SaBuMa/MEDICION-ANGULAR/Readme.md

# Medicíon Angular
***Resumen*** Este documento muestra la concepción, diseño,  implementación y operación de un sistema capaz de medir posición angular por medio de un Synchro/Resolver. Además, se presenta lo fundamental de la teoría para entender el funcionamiento del dispositivo junto con los resultados obtenidos.

***Abstract*** This paper presents from scratch the design process, the workings and the way to do a system capable of measuring the angular position using a Synchro/Resolver. Furthermore it is presented as the fundamental theory to understand the device along with the results obtained.  

Como características funcionales de este proyecto se tienen:

* Se diseñó e implementó un oscilador “puente de wien”, el cual es capaz de oscilar a una frecuencia de 400 Hz, con máxima excursión en su salida.

<p align="center">
<b>Esquemático del oscilador "Puente de Wien"</b>
</p>

<p align="center">
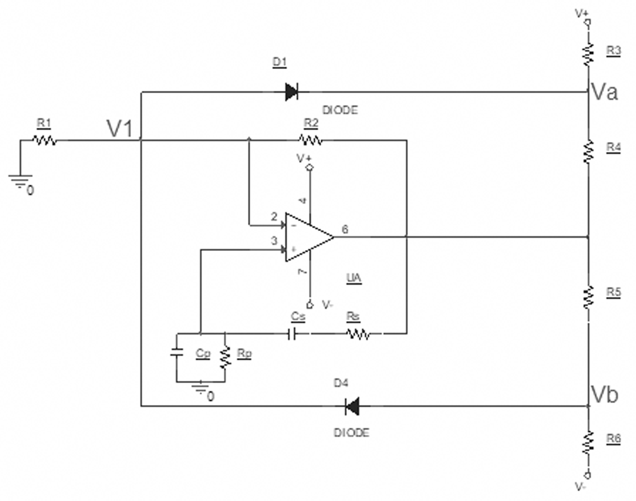
[picture p1: Git_Images/WEIN.png]
WEIN
  
</p>

* Se diseñó e implementó un circuito Scott-t, un Multiplicador y un Filtro pasa bajas.  

    * El circuito Scott-t, es para poder realizar la transformación de 3 señales provenientes del Synchro a dos señales, las cuales son aproximaciones de una onda seno y coseno respectivamente.
<p align="center">
<b> Esquemático transformador "Scott-t"</b>
</p>
<p align="center">
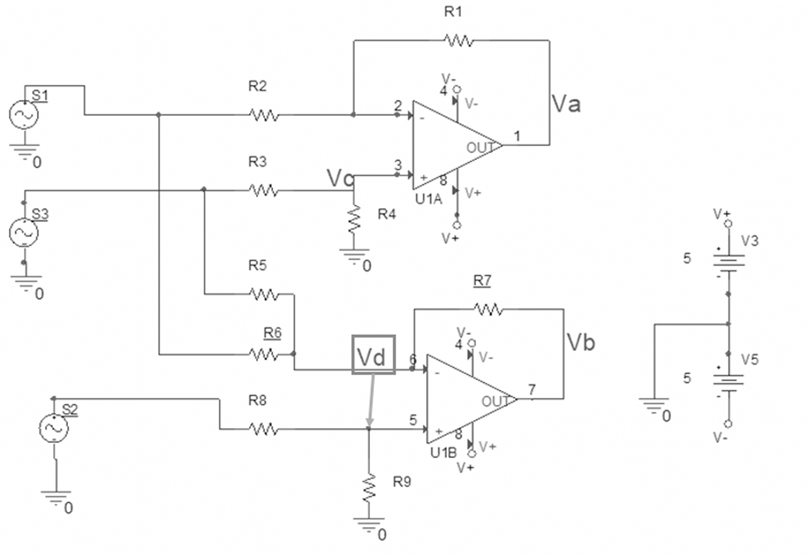
[picture p2: Git_Images/Scott-t.png]
Scott-t
  
</p>

* Se implementó un circuito multiplicador, el cual realiza la operación entre las señales seno y coseno provenientes del circuito Scott-t. (Se usó el integrado ***AD633ARZ***)
<p align="center">
<b> Circuito Multiplicador</b>
</p>
<p align="center">
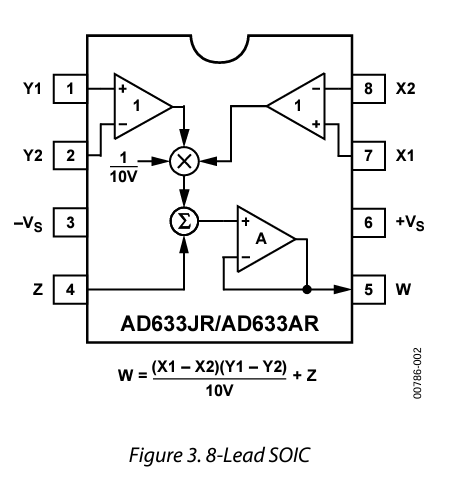
[picture p3: Git_Images/MultiplicadorPin.png]
MultiplicadorPin

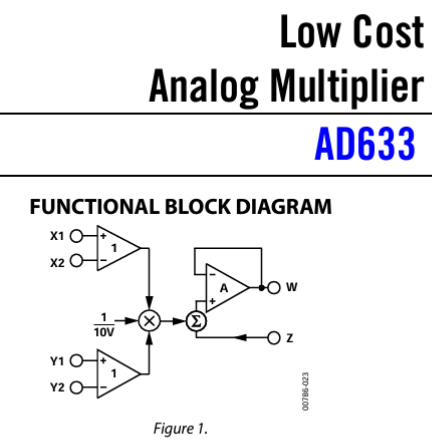
[picture p4: Git_Images/MultiplierDatasheet.png]
MultiplierDatasheet
 
</p>

* Se diseñó e implementó un Filtro pasa bajas a la señal proveniente del circuito multiplicador para obtener un valor DC.

<p align="center">
<b> Esquemático "Filtro pasa bajas"</b>
</p>
<p align="center">
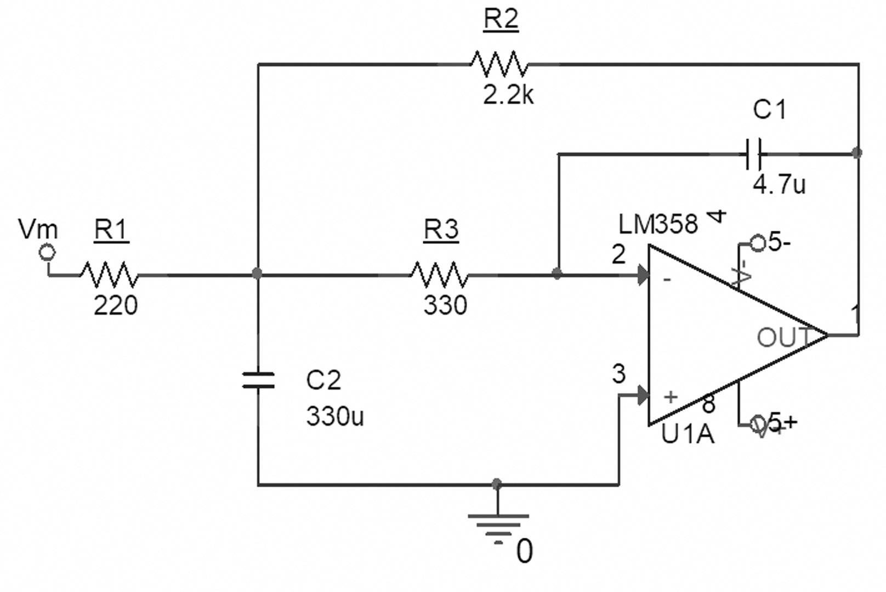
[picture p5: Git_Images/FiltroLP.png]
FiltroLP
  
</p>

* Se acondiciona la señal proveniente del filtro pasa bajas para que esta pueda ser leída y analizada por un Arduino.
<p align="center">
<b> Esquemático "Acondicionamiento de señal" </b>
</p>
<p align="center">
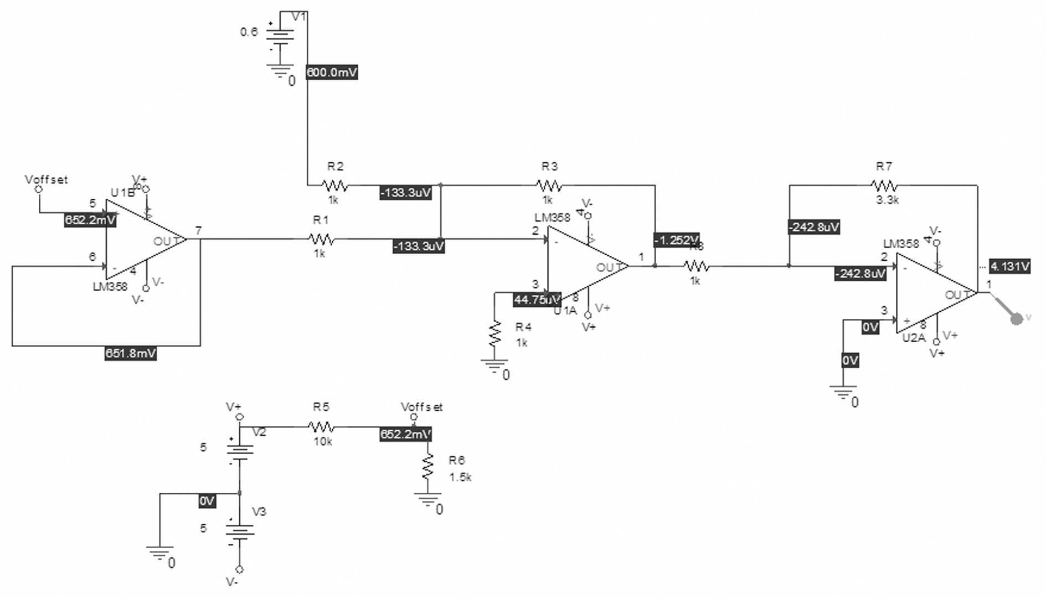
[picture p6: Git_Images/Acondicionamiento.png]
Acondicionamiento
  
</p>

* Se diseñó e implementó el código con el cual se determina la posición angular del rotor del Synchro haciendo uso de la señal descrita previamente, este código se realizó en el programa Arduino Software IDE. (__ARDUINO MEGA2560__)

<p align="center">
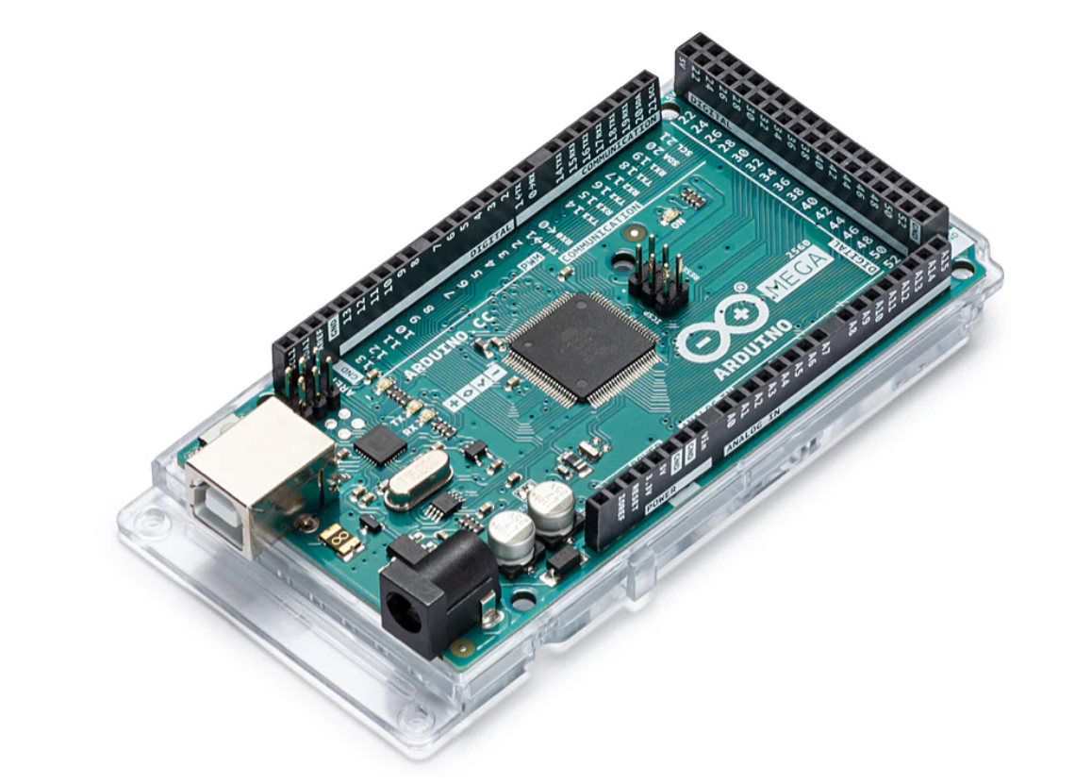
[picture p7: Git_Images/ArduinoMega.png]
ArduinoMega
  
</p>

## Esquemático del Proyecto
<p align="center">
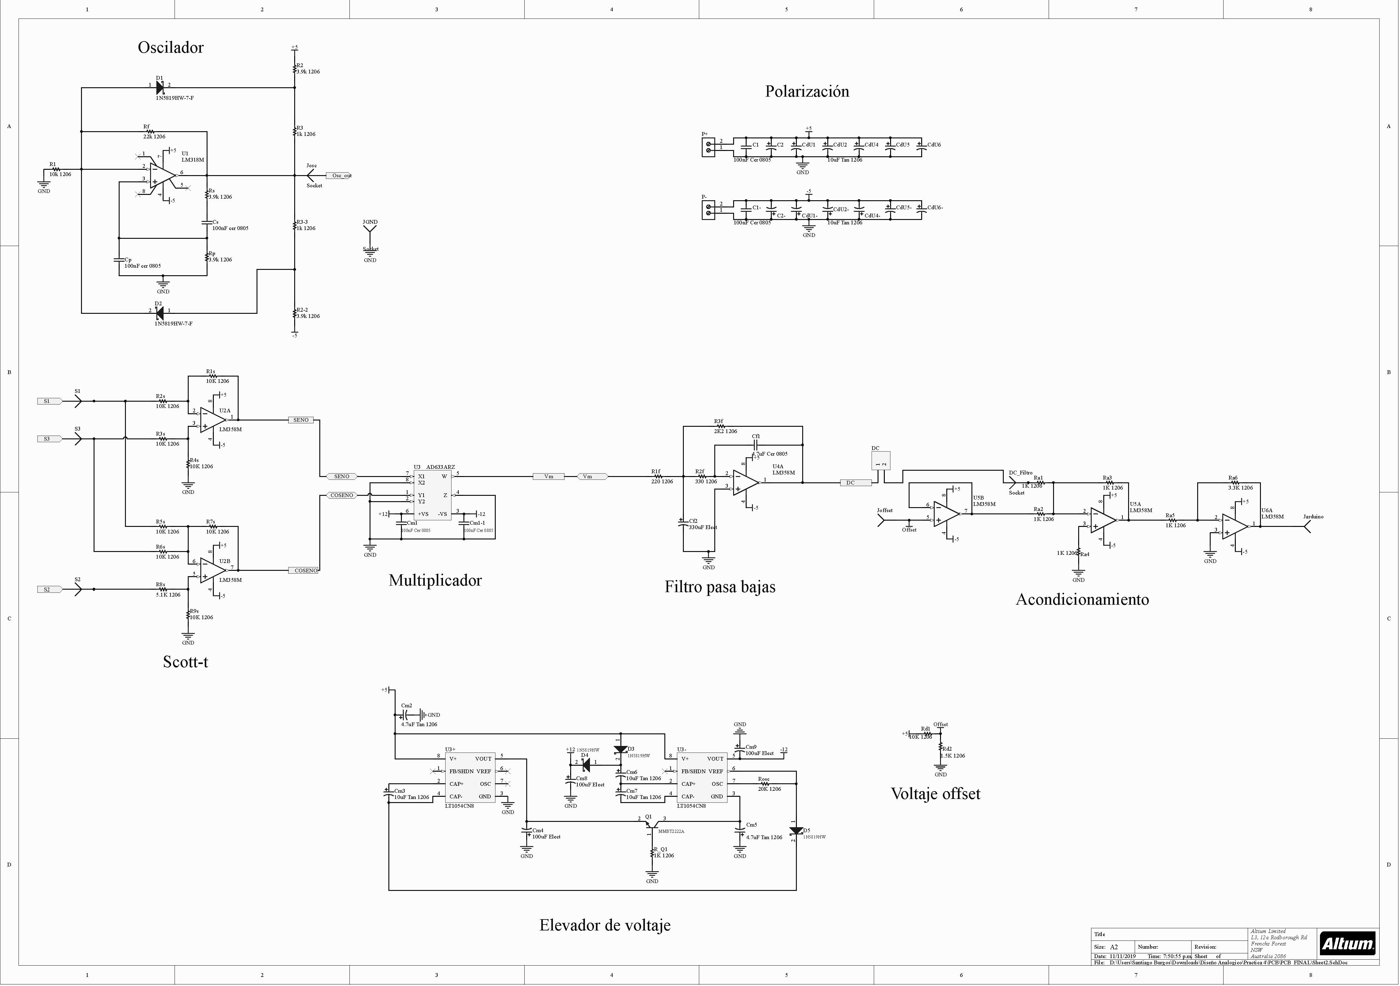
[picture p8: Git_Images/Esquematico.png]
Esquematico
  
</p>

## PCB del Proyecto
<p align="center">
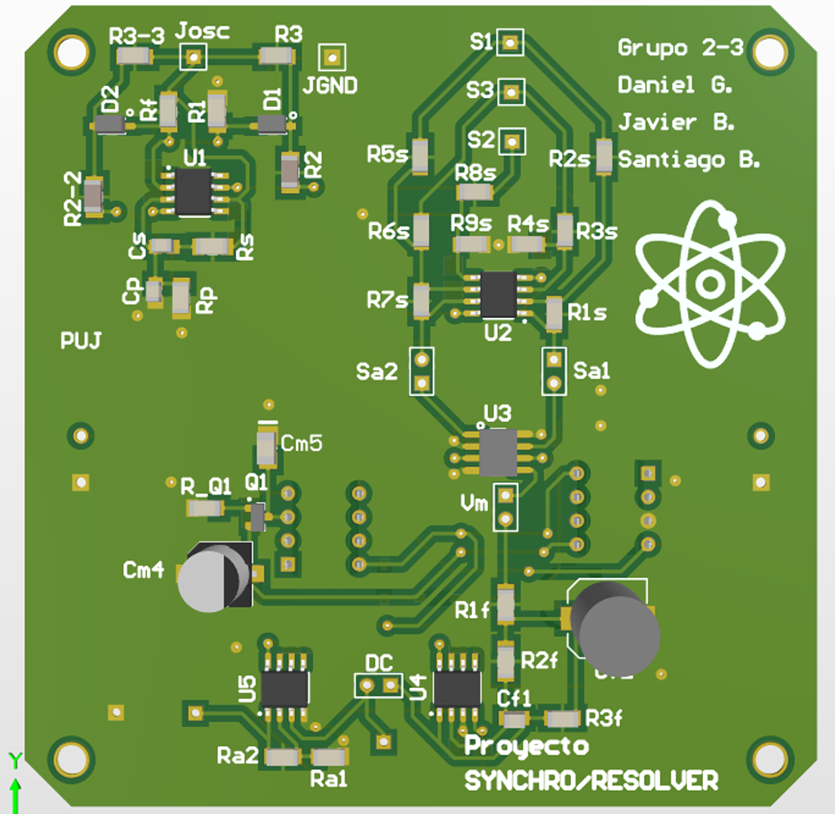
[picture p9: Git_Images/PCB1.png]
PCB1

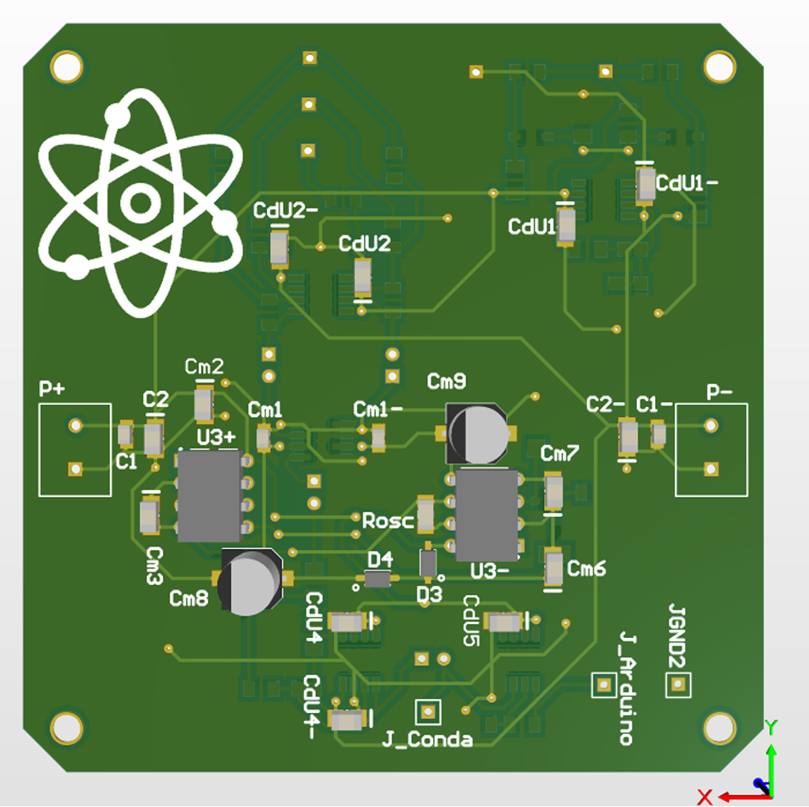
[picture p10: Git_Images/PCB2.png]
PCB2
  
</p>

## Referencias

* Synchro Clifton CTH - 10 - CYS - 4
* [Arduino(Nd).Arduino Mega 2560](https://store.arduino.cc/products/arduino-mega-2560-rev3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)
* Salz, K. (1998). How does synchros and resolvers
work.
* [Kessler, J. (1994). Synchro/resolver conversion
handbook. (631).](http://www.ddc-web.com/documents/synhdbk.pdf)
* [Synchro and Resolver Engineering Handbook.](https://www.moog.com/literature/MCG/synchrohbook.pdf)
* [Datasheet del integrado AD633](https://www.analog.com/media/en/technical-documentation/data-sheets/AD633.pdf)
* [Datasheet del integrado LM358M](http://www.ti.com/lit/ds/symlink/lm2904-n.pdf)
* [Datasheet del integrado LT1054](https://www.sigmaelectronica.net/manuals/LT1054.pdf)
* [National Semiconductor (1998). Operational
Amplifiers LM318.](https://www.sigmaelectronica.net/manuals/LM318.pdf)
6
* [Nota de aplicación. Active Low-Pass Filter
Design, de Texas Instruments.](http://www.ti.com/lit/an/sloa049b/sloa049b.pdf.)
* Sedra, A. S., & Smith, K. C. (2011).
Microelectronic circuits. Oxford University Press.
