SaBuMa/MEDICION-ANGULAR/Documentos-Info/CodigoArduino/Readme.txt

En esta carpeta se encuentra el codigo de arduino para observar el funcionamiento del proyecto
