SaBuMa/MEDICION-ANGULAR/Documentos-Info/Readme.txt

En esta carpeta se encuentran los documentos con la informacion del proyecto
