SaBuMa/MEDICION-ANGULAR/Documentos-Info/Esquematico.PDF

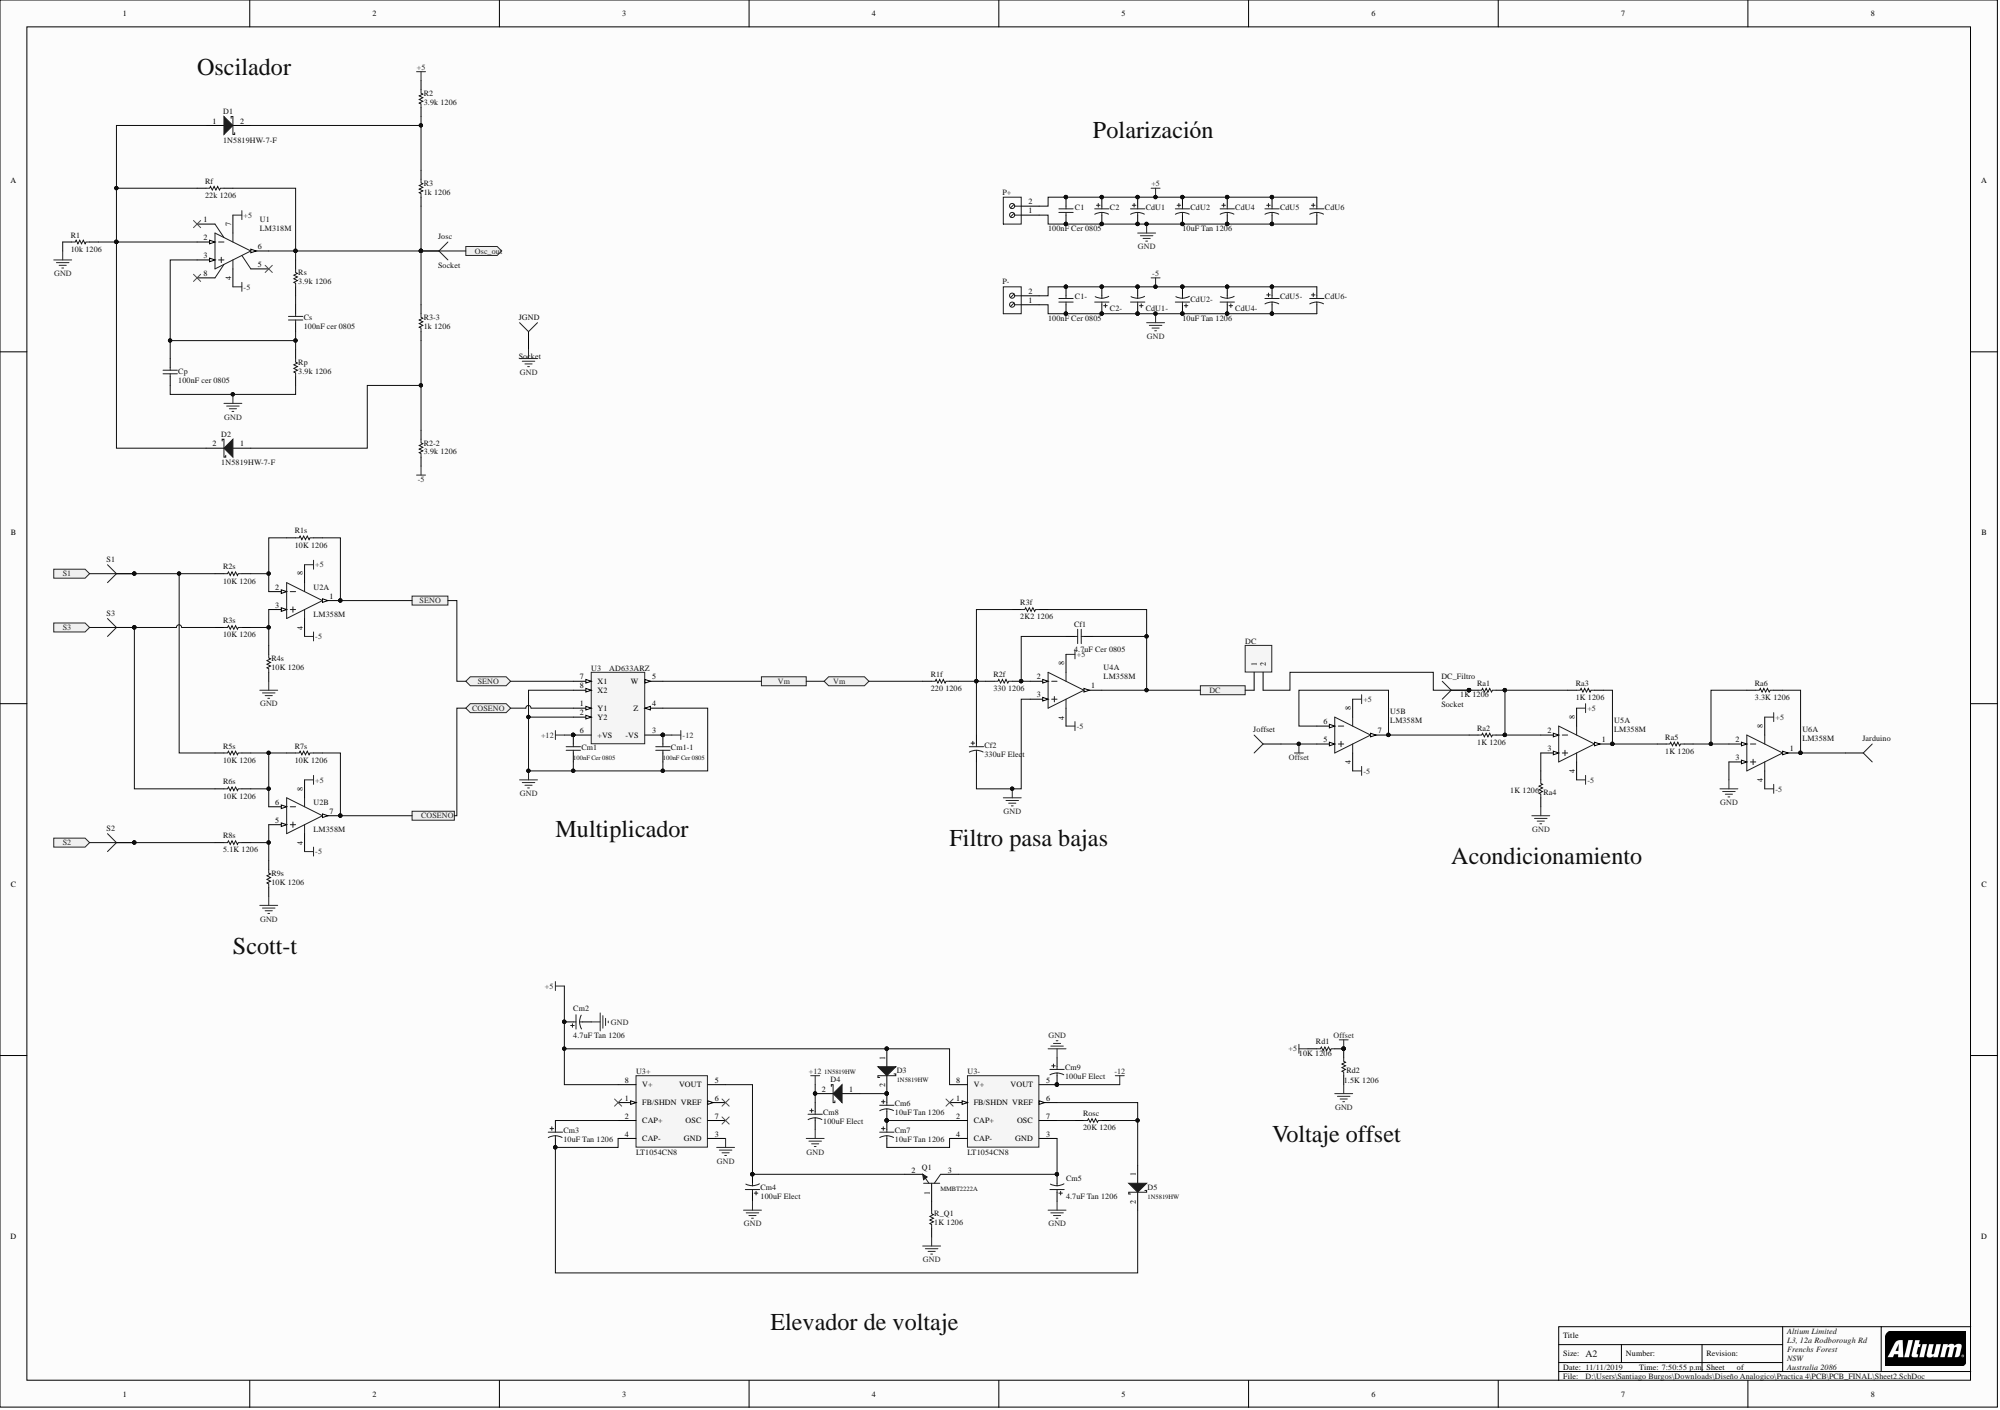
[picture p28: page 1]

Title | Altium Limited L3, 12a Rodborough Rd Frenchs Forest NSW Australia 2086

Size: A2 | Number: | Revision:
Date: 11/11/2019 Time: 7:50:55 p.m. | | Sheet of

D:\Users\Santiago Burgos\Downloads\Diseño Analogico\Practica 4\PCB\PCB_FINAL\Sheet2.SchDoc
