SaBuMa/MEDICION-ANGULAR/Documentos-Info/EsquematicosProyectoSynchro.pdf

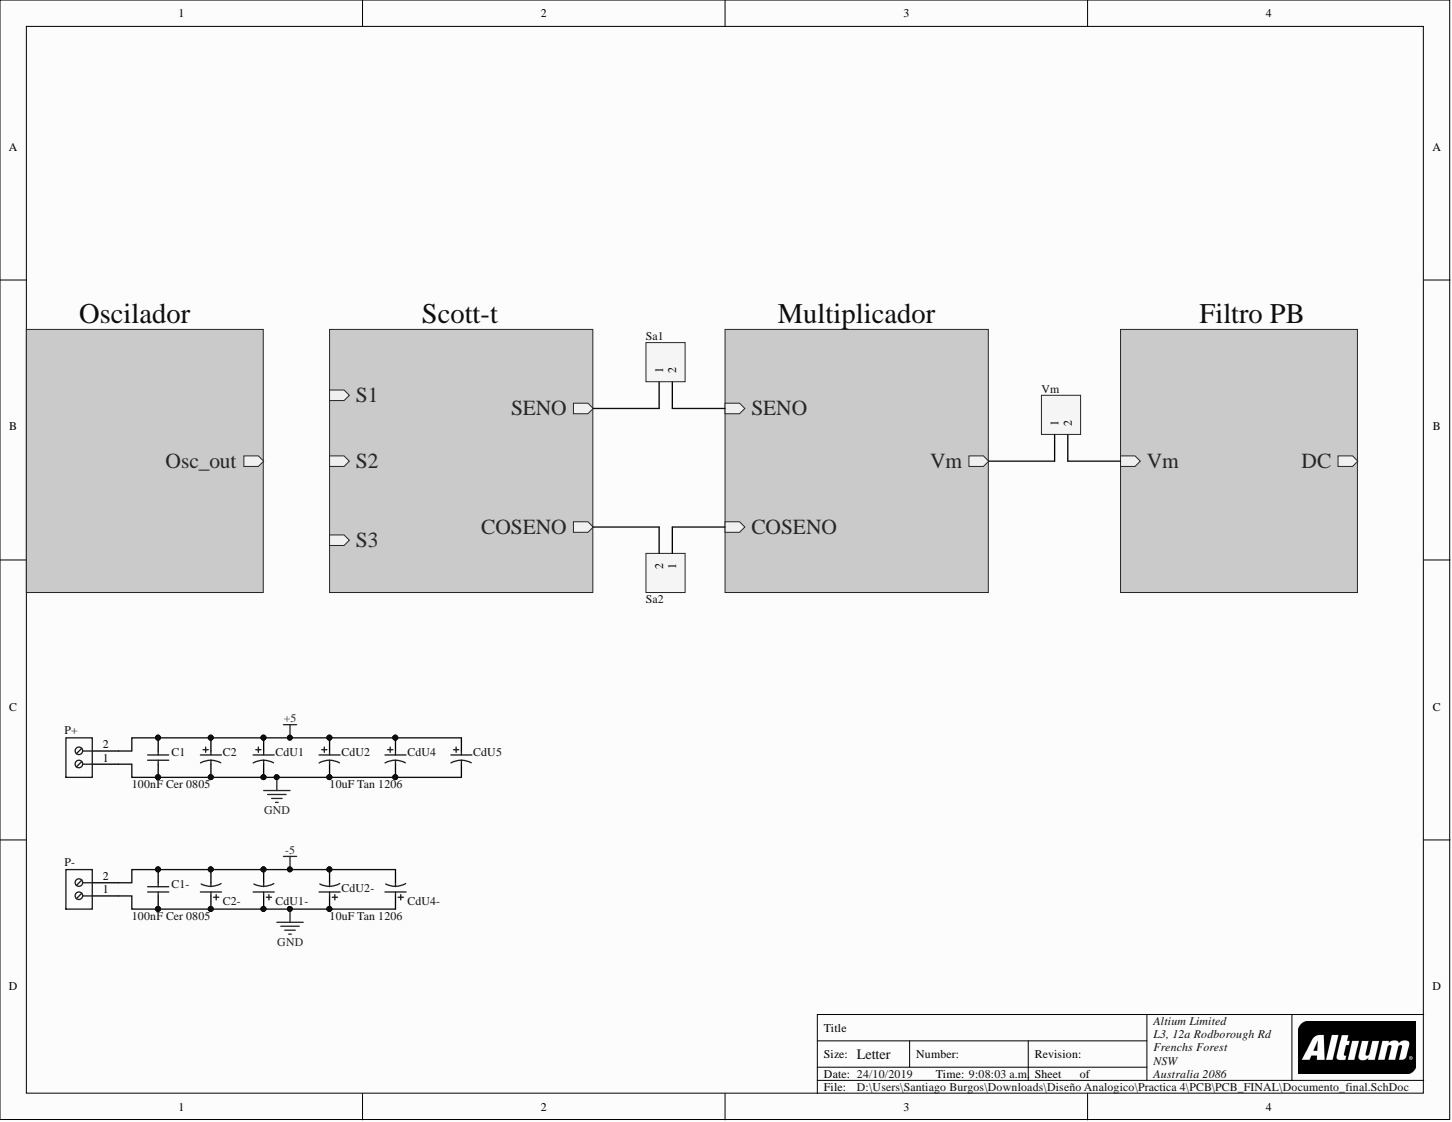
[picture p29: page 1]

Title | Altium Limited L3, 12a Rodborough Rd Frenchs Forest NSW Australia 2086

Size: Letter | Number: | Revision:
Date: 24/10/2019 Time: 9:08:03 a.m. | | Sheet of

D:\Users\Santiago Burgos\Downloads\Diseño Analogico\Practica 4\PCB\PCB_FINAL\Documento_final.SchDoc

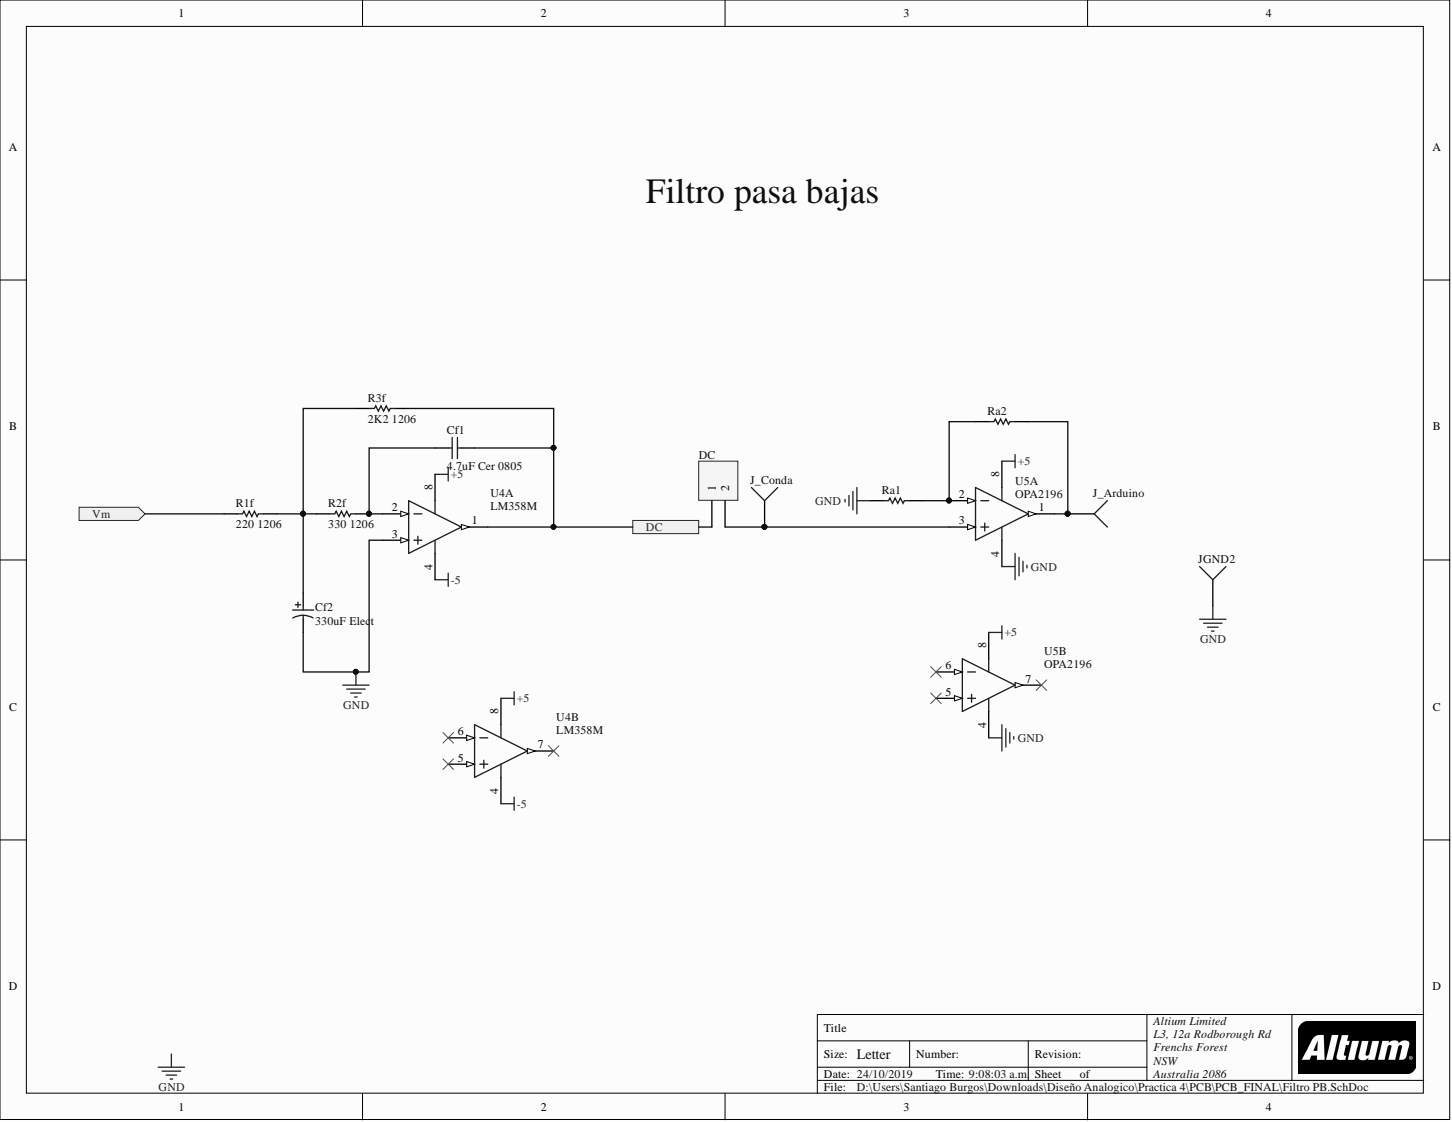
[picture p30: page 2]
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

Size: Lette r | N umber: | Rev i s i o n :

/ / T ime: : : 3 a.m. | | Sheet o f

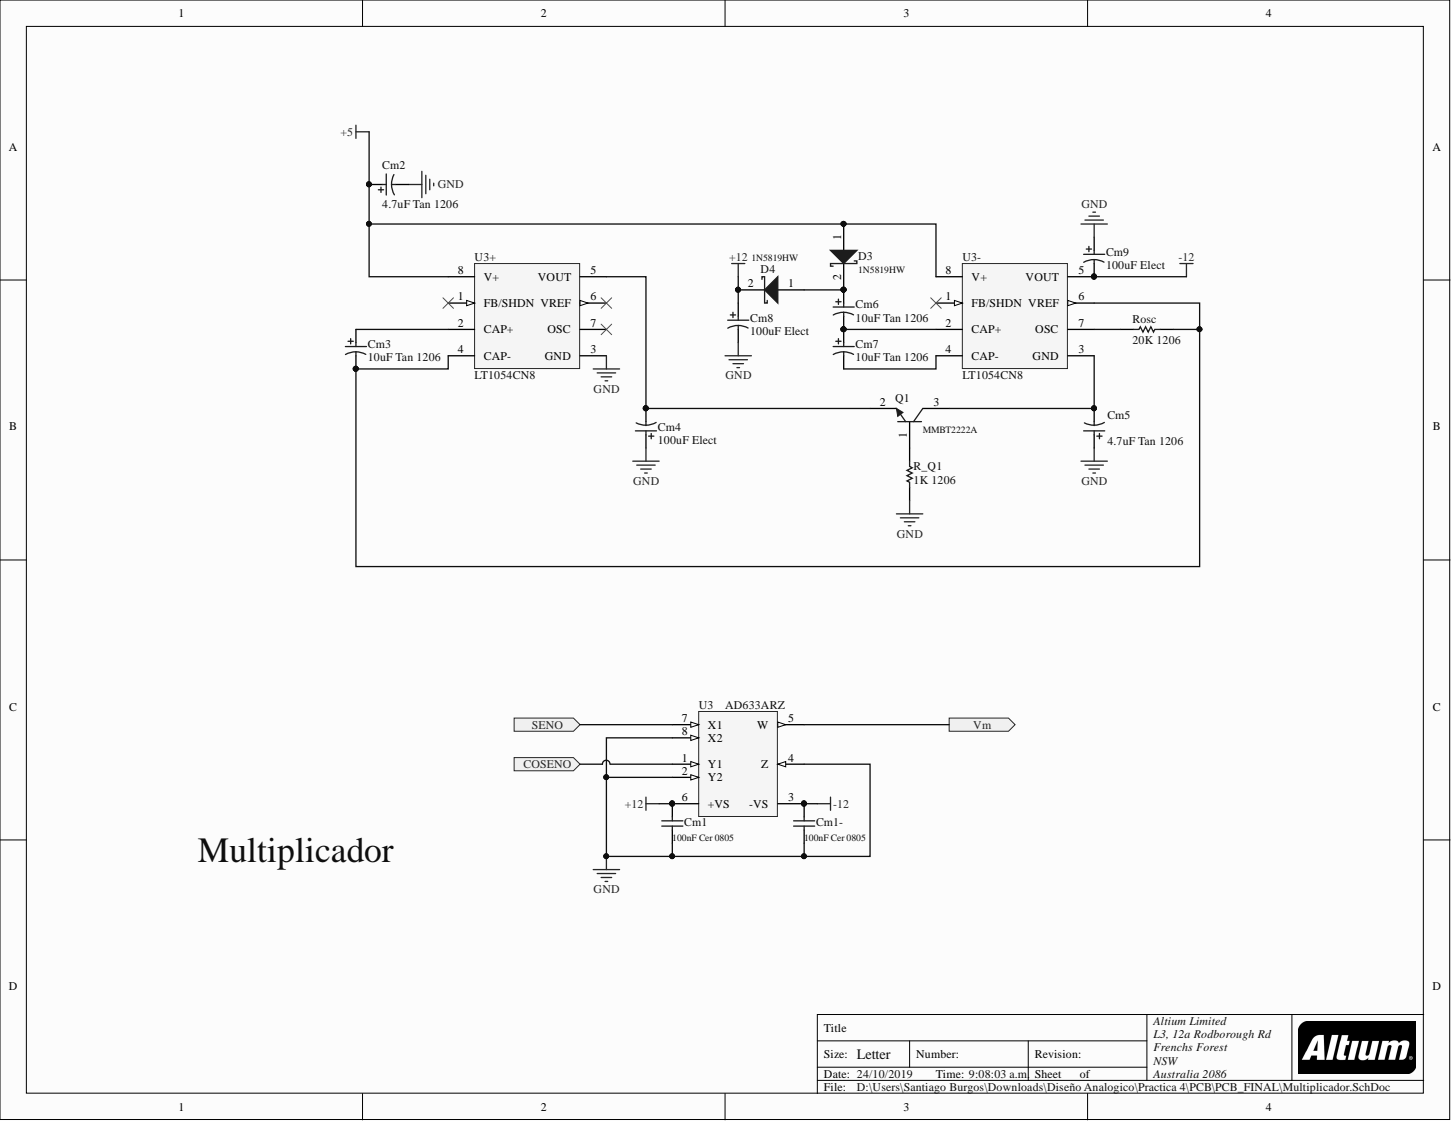
[picture p31: page 3]

D:\Users\Santiago Burgos\Downloads\Diseño Analogico\Practica 4\PCB\PCB_FINAL\Multiplicador.SchDoc

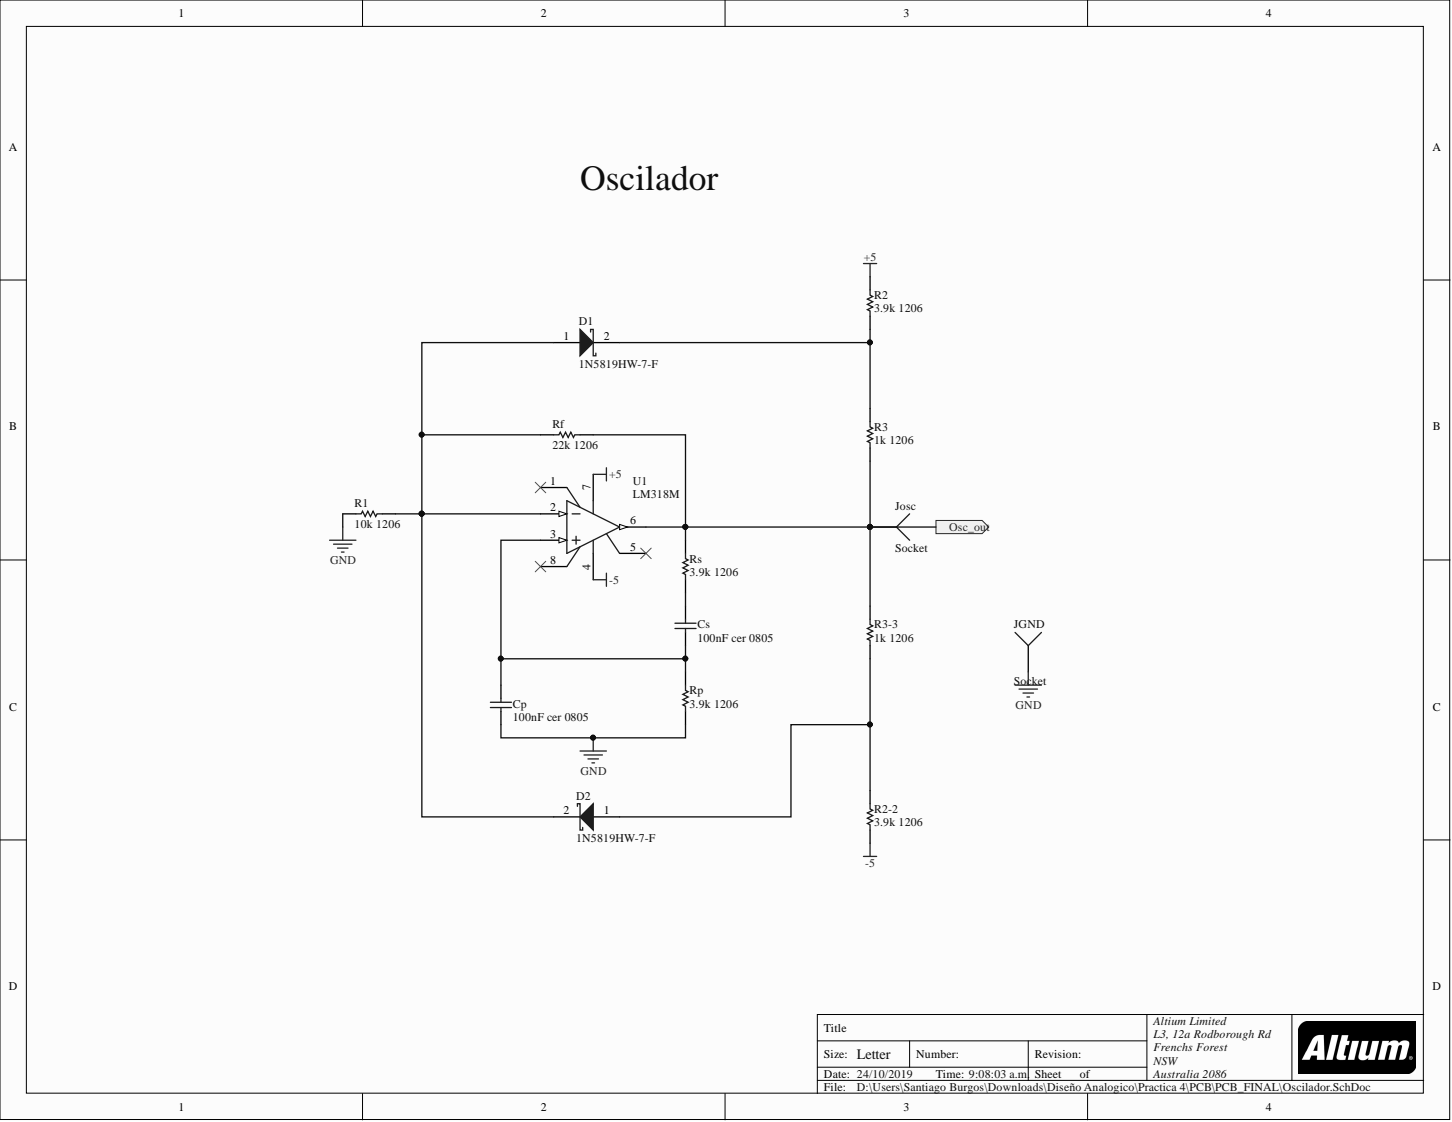
[picture p32: page 4]
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

Size: Lette r | N umber: | Rev i s i o n :

/ / T ime: : : 3 a.m. | | Sheet o f

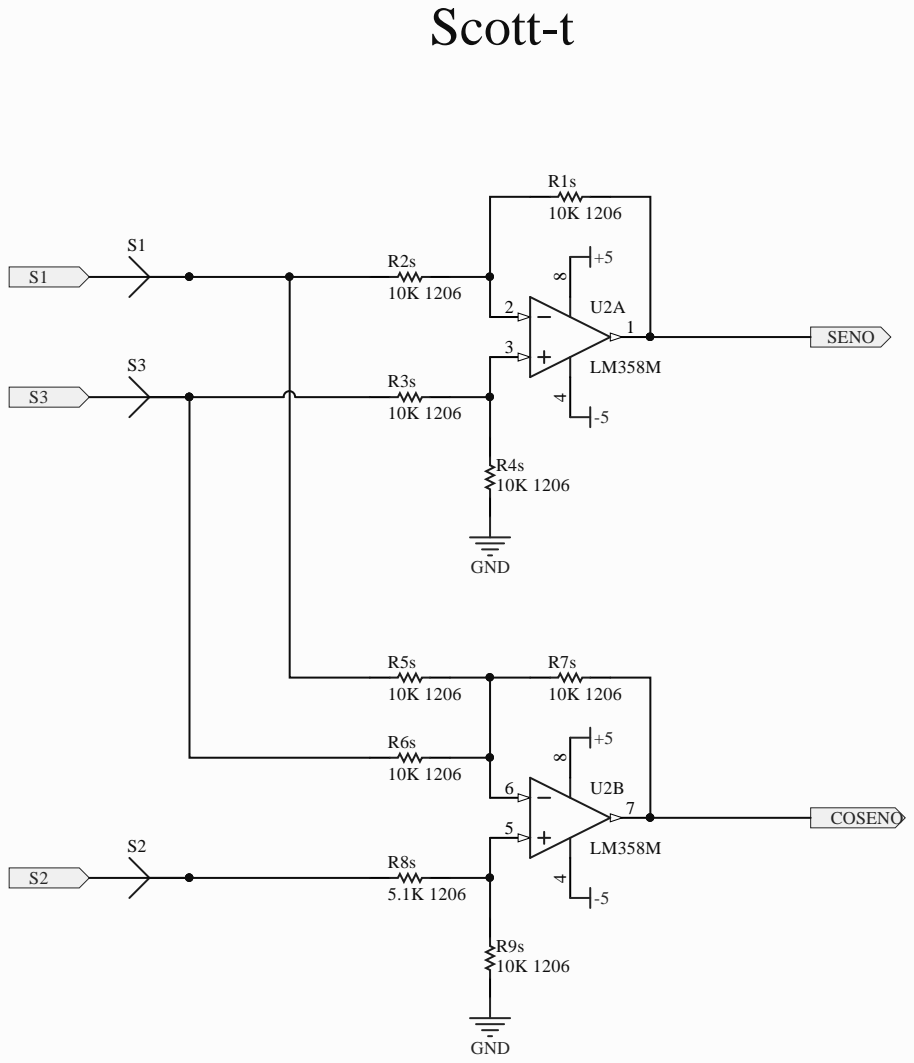
[picture p33: page 5]

D:\Users\Santiago Burgos\Downloads\Diseño Analogico\Practica 4\PCB\PCB_FINAL\Scott-t.SchDoc
